ademuri/rfboard/hardware/ref/seed bom.xlsx

Designator | Manufacturer Part Number or Seeed SKU | Qty | Link
J1 | 10118194-0001LF | 1
D1 | WS2812B | 1
D2 | SML-D12U1WT86 | 1
U1 | ATSAMD21E17A-AU | 1
U3 | TCR2EF33,LM(CT | 1
C1, C2, C4, C5 | CL10A105MP8NNNC | 4
C3 | CL21A106KPFNNNG | 1
R2 | RMCF0603JJ1K00 | 1
U4 | 74LVC1G125GW,125 | 1
S1 | KMR442GULCLFS | 1 | https://www.digikey.com/product-detail/en/c-k/KMR442G-ULC-LFS/CKN11065CT-ND/7355937
C7 | CL10C010CB8NNNC | 1
L1 | LQW18AN10NG00D | 1
