ademuri/rfboard/hardware/rfboard_v1.6.step

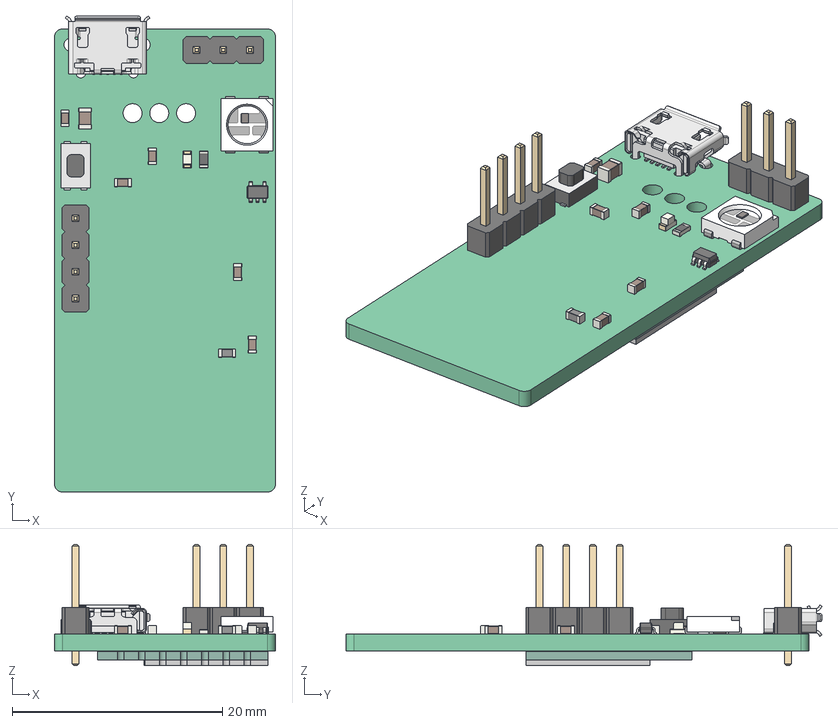
[picture p1: CAD file, 2020-08-04]
hardware/rfboard_v1.6.step
21.0 x 45.2 x 11.5 mm
Local_CS_85a
Pcb_85a
PCB_Sketch_85a
D1_risk1E78E08Bni4a_5D7EE1BD
S1_KMR442G_5D7EE969
J1_10118194C_5D7EE202
C1_C_0603_1608Metric_5D7EE14A
C2_C_0603_1608Metric_5D7EE15B
C4_C_0603_1608Metric_5D7EE17D
C5_C_0603_1608Metric_5D7EE18E
C7_C_0603_1608Metric_5D7EE1B0
L1_L_0603_1608Metric_5D7EE213
R2_R_0603_1608Metric_5D7EE224
D2_LED_0603_1608Metric_5D7EEA00
P2_PinHeader_1x03_P254mm_Vertical_5D7EEA76
P3_PinHeader_1x04_P254mm_Vertical_5D7EE9C0
U4_SOT_353_SC_70_5_5D7E9620
C3_C_0805_2012Metric_5D7E94F2
U2_RFM69CW_rough_5D7EE2FC
