ademuri/rfboard/hardware/rfboard.kicad_pcb

## KiCad design hardware/rfboard.kicad_pcb (2019-09-28)

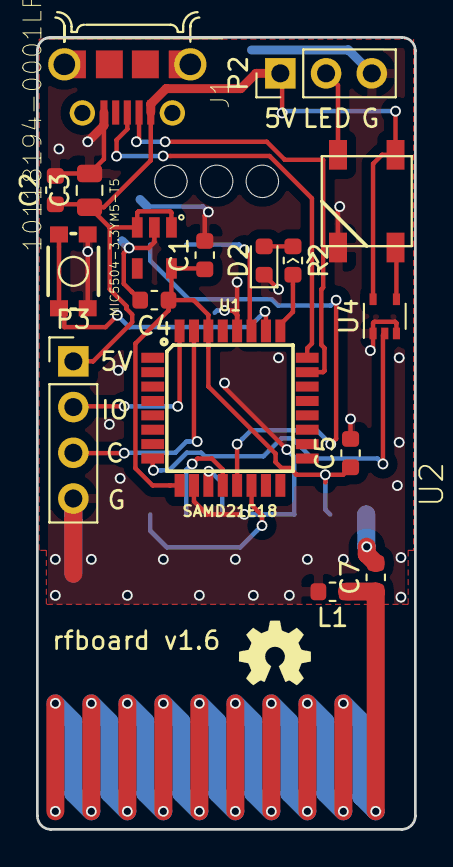
[picture p2: board rfboard.kicad_pcb from above]

Board: 2 copper layers, 21.0 x 44.0 mm, 19 parts (1 on the bottom side), 20 nets.

Parts:
C1, C2, C4, C5: 1uF; C_0603_1608Metric
C3: 10uF; C_0805_2012Metric
C7: 1pF; C_0603_1608Metric
D1: WS2812B
D2: LED; LED_0603_1608Metric
H3: STRAIN_RELIEF; 3_pin_2.54mm_pitch_strain_relief
J1: 10118194-0001LF; FRAMATOME_10118194-0001LF_fixed_bridges
L1: 10nH; L_0603_1608Metric
P2: CONN_01X03; PinHeader_1x03_P2.54mm_Vertical
P3: CONN_01X04; PinHeader_1x04_P2.54mm_Vertical
R2: 1k; R_0603_1608Metric
S1: MOMENTARY-SWITCH-SPST-SMD-4.6X2.8MM; TACTILE_SWITCH_SMD_4.6X2.8MM
U1: SAMD21E18; TQFP32-08
U2: RFM69CW-915MHZ; RFM69CW-minimalpads
U3: MIC5504-3.3YM5-T5; SOT23-5P95_280X145XL45X37N
U4: 74LVC1G125; SOT-353_SC-70-5

Connections:
+3V3: C1.1, C4.1, C5.1, U1.9, U1.30, U2.2, U3.5
+5V: C2.1, C3.1, D1.1, J1.1, P2.1, P3.1, U3.1, U3.3, U4.5
ANTENNA: C7.1, L1.1
ARM_SWCLK: P3.3, U1.31
ARM_SWDIO: P3.2, U1.32
GND: C1.2, C2.2, C3.2, C4.2, C5.2, D1.3, D2.1, J1.5, L1.2, P2.3, P3.4, S1.1, S1.2, U1.10, U1.28, U2.3, U2.14, U3.2, U4.1, U4.3
LED_EXTERNAL: D1.2, P2.2
LED_INTERNAL: U1.8, U4.2
unnamed: C7.2, U2.1
unnamed: D1.4, U4.4
unnamed: D2.2, R2.1
RADIO_DIO0: U1.27, U2.9
RADIO_MISO: U1.13, U2.8
RADIO_MOSI: U1.11, U2.5
RADIO_NSS: U1.14, U2.7
RADIO_SCK: U1.12, U2.6
RESET_SW: S1.3, S1.4, U1.26
SIMPLE_LED: R2.2, U1.25
USB_D+: J1.3, U1.24
USB_D-: J1.2, U1.23
