ademuri/rfboard/(commit log)

2018-02-15 Create the schematic
    [rfboard.kicad_pcb, rfboard.sch]
2018-02-15 Associate footprints
    [rfboard.sch]
2018-02-15 Layed out the components.
    [rfboard.sch]
2018-02-16 Move right header to match breadboard spacing (2.54mm pitch)
    [rfboard.kicad_pcb]
2018-02-16 Finished layout.
    [rfboard.kicad_pcb, rfboard.sch]
2018-02-16 Optimized ground plane
    [rfboard.kicad_pcb]
2018-02-16 Make board narrower
    [rfboard.kicad_pcb]
2018-02-16 Add silkscreen
    [rfboard.kicad_pcb]
2018-07-08 Hardware revision 1.1:
    - Add a buffer to bump up the signal to the serial LED to 5V
    - Switch SWD progamming input voltage to 5V
    - Add a reset button
    - Remove two less-useful pins
    - Make the board two breadboard rows smaller
    [_saved_rfboard.sch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]
2019-03-07 Hardware revision 1.2:
    - Add pullup resistors for doing I2C
    - Added a helical antenna (untested)
    [_saved_rfboard.sch, rfboard.kicad_pcb, rfboard.sch]
2019-05-10 Hardware revision v1.3:
    - Add decoupling caps for micro and radio
    - Replace antenna with hole (fix placement slightly)
    - Updated to KiCAD v5
    [rfboard-2019-05-09-19-43-53.sch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]
2019-05-16 Generate v1.3 reference files
    [rfboard.kicad_pcb]
2019-07-11 Hardware revision v1.4:
    - Add solder mask dam between pads on processor, regulator, buffer, and USB port
    - Move antenna to not interfere with RFM69
    - Added strain relief holes for LED connector
    - Move USB capacitors down slightly to aid in fixing USB port shorts
    - Fixed labeling of 3v3 pin
    [rfboard-B_CrtYd.gbr, rfboard-B_Cu.gbr, rfboard-B_Fab.gbr, rfboard-B_Mask.gbr, rfboard-B_Paste.gbr, rfboard-B_SilkS.gbr, rfboard-Edge_Cuts.gbr, rfboard-F_CrtYd.gbr]
2019-07-22 Revision v1.5:
    - Fix size of strain relief holes
    - Reduce size of stencil holes for USB port
    [rfboard-B_CrtYd.gbr, rfboard-B_Cu.gbr, rfboard-B_Fab.gbr, rfboard-B_Mask.gbr, rfboard-B_Paste.gbr, rfboard-B_SilkS.gbr, rfboard-Edge_Cuts.gbr, rfboard-F_CrtYd.gbr]
2019-09-28 Revision 1.6:
    - Add PCB trace antenna, based on: http://www.ti.com/lit/an/swra416/swra416.pdf
    - Change form factor to be slightly narrower
    [rfboard-B_CrtYd.gbr, rfboard-B_Cu.gbr, rfboard-B_Fab.gbr, rfboard-B_Mask.gbr, rfboard-B_Paste.gbr, rfboard-B_SilkS.gbr, rfboard-Edge_Cuts.gbr, rfboard-F_CrtYd.gbr]
2020-08-04 Add 3d model for board
    [rfboard_v1.6.step]
2022-10-02 Add partial 3d model for rfboard
    [rfboard.sch]
